nico5997/LCD-Controller-DE0-Nano-Soc/README.md

# LCD-Controller-DE0-Nano-Soc
The goal of this lab is the design of custom master interface for an LCD Controller.
